Open-Smartwatch/open-smartwatch-light/docs/LILYGO-TTGO-Micro-32-V2-0.jpg

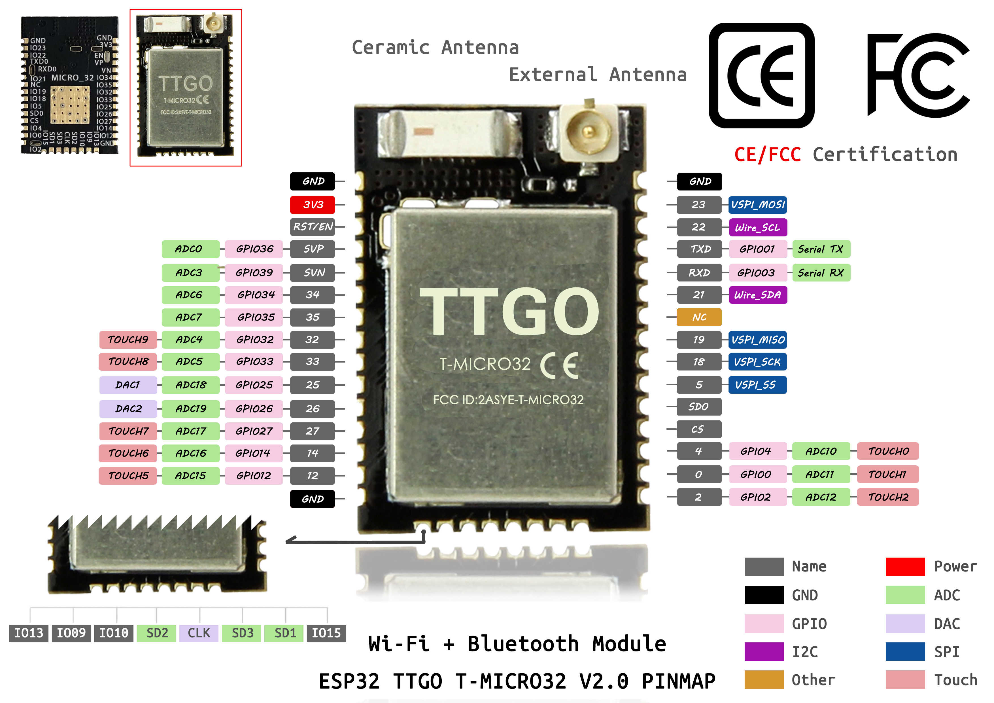
docs/LILYGO-TTGO-Micro-32-V2-0.jpg
