Open-Smartwatch/open-smartwatch-light/docs/TTGO-Micro-32-vs-ESP32-WROOM-32.jpg

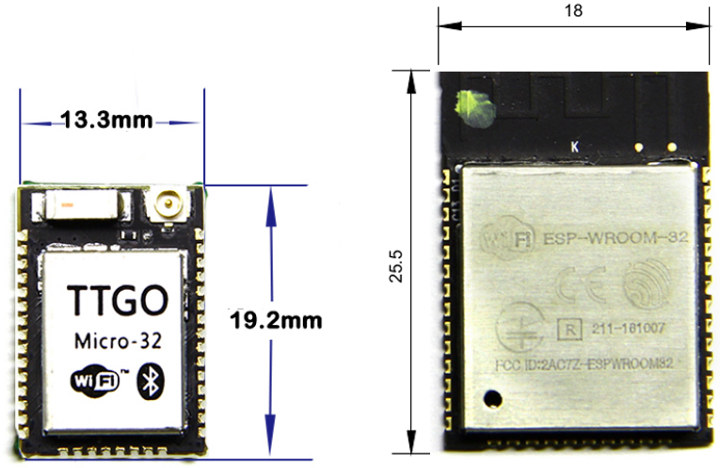
docs/TTGO-Micro-32-vs-ESP32-WROOM-32.jpg
