Open-Smartwatch/open-smartwatch-light/README.md

# Open-Smartwatch KiCAD files

Repo for kicad schematic, board and gerber files. This project is in development and is not ready for release.

## Tools

To view/modify the files from this repository, install KiCAD from: [https://kicad.org](https://kicad.org)

Also, add the following Symbol/Footprint library to KiCAD: [https://github.com/Open-Smartwatch/Kicad-Libraries](https://github.com/Open-Smartwatch/Kicad-Libraries)

## Schematic
Schematic

## Plots
front
bottom

## BOM

See: [https://htmlpreview.github.io/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](https://htmlpreview.github.io/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)
