Open-Smartwatch/open-smartwatch-light/docs/osw-schematic.pdf

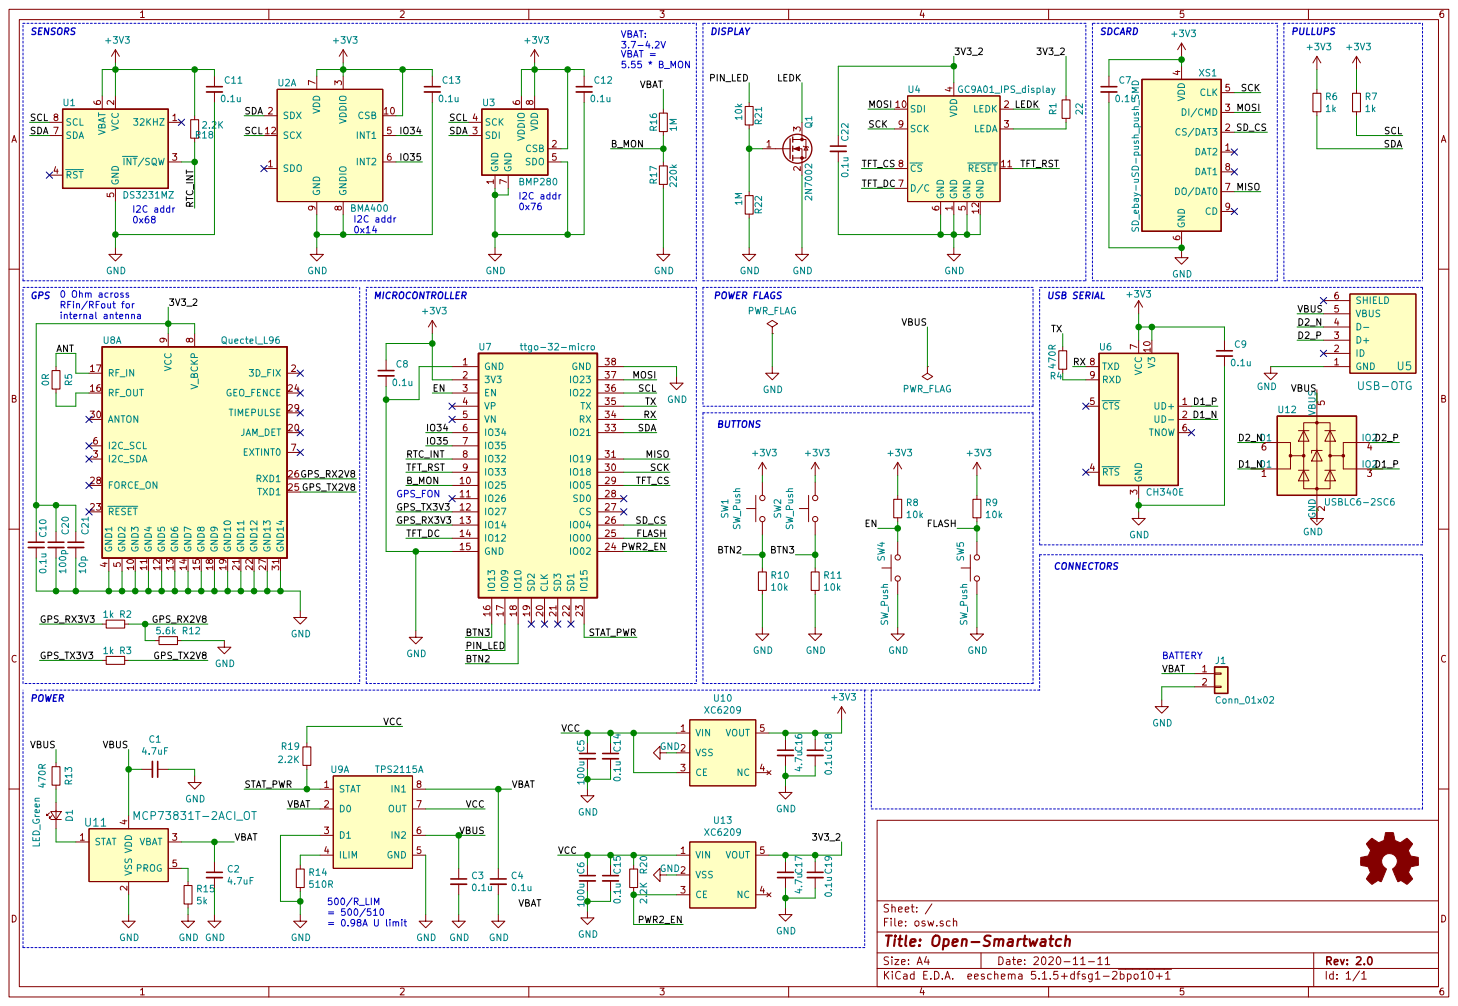
[picture p3: page 1]

6 DO/DAT0 7 DAT1 8 CD 9 XS1 SD_ebay-uSD-push_push_SMD R16 1M GND

1 CSB 2 SDI 3 SCK 4 SDO 5 VDDIO

0 Ohm across RFin/RFout for

3 RTS 4 CTS 5 TNOW 6 VCC

Id: 1/1 Title: Open-Smartwatch
