Open-Smartwatch/open-smartwatch-light/docs/osw-light-schematic.pdf

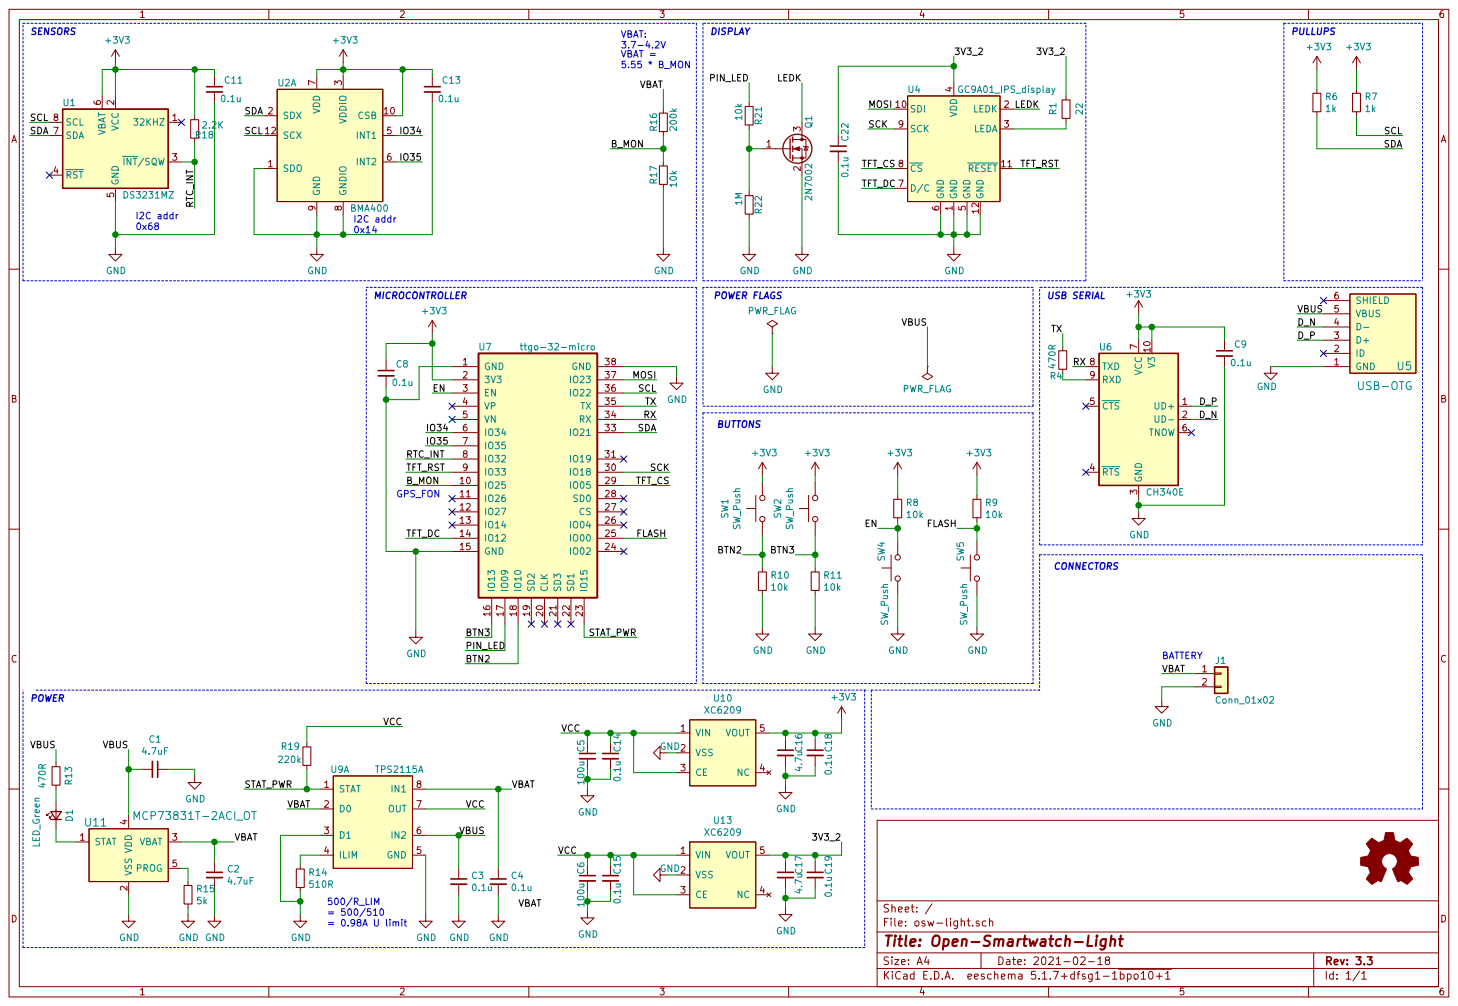
[picture p4: page 1]

3 RTS 4 CTS 5 TNOW 6 VCC

Id: 1/1 Title: Open-Smartwatch-Light
