Open-Smartwatch/open-smartwatch-light/(threads)

Thread 3 (2021-04-09):

Replace the micro32 module with an onboard esp32 pico d4

uvwxy, 2021-04-09:
The thickest part of the current design is the ttgo micro-32 module. If we place the esp pico d4 chip directly on the PCB we would get more space to maybe add additional ram (see GPS edition on how to add ram).

Electro707, 2021-04-10:
There is also the [ESP32­PICO­MINI­02](https://www.espressif.com/sites/default/files/documentation/esp32-pico-mini-02_datasheet_en.pdf) by Espressif, which is slightly smaller than the current module used (13.2×16.6×2.4mm).

Also by thickest you mean the biggest in size?

uvwxy, 2021-04-11:
> Also by thickest you mean the biggest in size?

yes.

uvwxy, 2021-04-11:
I'm also looking at developing a custom module fitting the footprint, that already includes the PSRAM for an additional 4MB RAM

uvwxy, 2021-04-13:
Update: the custom module is not going to work in a nice way.

Sharealikelicence, 2021-04-22:
Only issue I can see with this is getting FCC approval for the design to pass the RF leakage regulations etc.

Electro707, 2021-04-22:
> Only issue I can see with this is getting FCC approval for the design to pass the RF leakage regulations etc.

Well that should only apply if the watch is sold (and not as a kit). Otherwise as long as it's not poorly designed it shouldn't need approval/official testing (maybe tough a home-made test should be done just to make sure it doesn't spew crap out). At least as far as I'm aware.

Sharealikelicence, 2021-04-23:
Definitely not my field of expertise, but why does the micro32 board have FCC compliance as it is arguably sold in kit form? I'm thinking, for any commercial partners to pick up the design, RF leakage tests will have to be performed otherwise they probably won't take it on? I have no idea about that though.

Electro707, 2021-04-23:
Because the Micro32 is not sold as a kit, but instead as a module to be incorporated in a product. The advantage of the FCC compliance there is that the OEM using the module won't have to certify it for whatever certifications for intentional radiators it needs (they still need to do a Part15 non-intential radiator compliance, but that's one less certification/testing they need to do). As least as far as I'm aware.

As for this project, official FCC certification won't be required as it's not being sold (and if it is, it's done so as a hobbyist-oriented kit which is exempt from needing official certifications).

Sharealikelicence, 2021-04-27:
Yeah, I was thinking mainly designing it so it "should" pass FCC compliance, not actually do it. My original thought was to just duplicate the micro32 design onto the board. But, it's not open source, from what I can find, and I'm not sure about the copper layer count etc.

carlos-ramos-73, 2022-04-24:
> There is also the [ESP32­PICO­MINI­02](https://www.espressif.com/sites/default/files/documentation/esp32-pico-mini-02_datasheet_en.pdf) by Espressif, which is slightly smaller than the current module used (13.2×16.6×2.4mm).
>

I took a look into the ESP32 PICO MINI 02, It looks very promising for a replacement with the exception of the pads for soldering. Which, for an open source hobby kit, I think is a big deal when it comes to accessibility. But I do agree that if we can make it smaller, then it might be worth the tradeoff.

uvwxy, 2022-06-10:
Done with the latest design:

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

(there are still some bugs I need to resolve in the design. Patience ;) )

Closed 2022-06-10.

Thread 4 (2021-04-10):

Feature: Wireless Chargin

Electro707, 2021-04-10:
I think that a wireless charger built-in would be handy for everyday smartwatch usage. Preferably it should be Qi compliant so that any regular charger will work. Something like the [BQ51013B](https://www.ti.com/lit/ds/symlink/bq51013b.pdf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) or the [bq5105xB](https://www.ti.com/lit/ds/symlink/bq51050b.pdf?HQS=dis-dk-null-digikeymode-dsf-pf-null-wwe&ts=1618078894402) should work fine. Space on the board might be troublesome tough.

uvwxy, 2021-04-11:
Currently, in the deep sleep and tap to wake up configuration the battery can last over a week.

I'd prefer a magnetic clip/external interface versus wireless charging, especially due to the size constraints.

Maybe for a Version 4/ Version 5 :)

Tomaskocarter, 2021-06-19:
The only real benefit to wireless charging would be the increased water resistance imo.

Thread 5 (2021-04-22):

Feature: External Flash Memory

Sharealikelicence, 2021-04-22:
To allow users to change settings on their devices without having to re-flash the firmware and have them persist after a reboot, it would be handy to have a small amount of external memory (something like a [AT24C02C](https://www.microchip.com/wwwproducts/en/AT24C02C)) to be able to save the settings to.
This would then open up things like being able to change WiFi hotspots/passwords and default views on the fly.

Sharealikelicence, 2021-04-22:
Apparently the new esp pico d4 mentioned in #3 contains 4MB of integrated SPI flash memory which will make this feature request mute.

Closed 2021-04-22.

Thread 6 (2021-05-20):

Is it an option to customise the watch?

NavehKh, 2021-05-20:
Hi,

We are two friends in high school and we learn in a special program for youth at the university. As a final year project we chose to create a watch that has an alarm for deaf people.

The idea was to create a hand watch with pulse and movement sensors, a microphone, and a small electric shocker. When the time's up the watch sends little electric shocks until our guy is awake (what we learn from the sensors).

We looked all over the internet and we decided to use this DIY smartwatch as a basis for our project (this one - https://open-smartwatch.github.io/). It looked great, very functional and we can see you put a lot of effort in it.

We would like to know: can we plug the pulse sensor, the microphone, and the electric shocker to your open source smartwatch? Does the controlling unit (the ESP32-pico-D4) have input and output plugs that will allow us to connect the sensors to the watch?
If all the above are possible, we would like to get some help how to do it 🙏.

Thanks a lot in advance,

Eitan Givon and Naveh Khagbi

Electro707, 2021-05-31:
Assuming that the pulse sensor is an analog output, the module does have an internal ADC that can be used for that
For the shocker, depends on what it needs. If a 3.3v power rail will suffice, it can be done with a transistor switch configuration to drive it. Otherwise an internal boost converter can be used.
For the microphone, I would recommend some external microphone -> (I2C, SPI, or I2S) driver/interface as the internal ADC might not be fast enough for audio.

The watch PCB doesn't have pads to solder other stuff to it. And while you can hack in magnet wires to the ESP module and have an external circuitry for your peripherals, I would recommend forking the design and changing the PCB to fit your needs.

Closed 2022-06-09.

Thread 7 (2021-06-24):

Creating a smartphone App for the watch

kekko7072, 2021-06-24:
Hey I really like this open-sourche project.
I like to contribute developing a mobile phone app (using flutter) to connect the watch to iOS/Android smartphone.
To start using the clock and creating the app I will buy it from makerfabs the light edition and start developing.

I can comunicate with the watch through bluetooth, right?

Sensor now available:
+ Pedometer

In this first version of the app my goals will be:
+ Create a stable protocol of connection
+ Show Pedometer data in the app
+ Integration with Health Kit (Apple) and Google Fit.

For the future I'd like to use the data from this sensor:
+ Pulse sensor
+ Blood Oxygen Saturation
+ Altitude (I think is just in GPS version)

Using this sensor, In this second version of the app my goals will be:
+ Create sport watch  functions (ex. running)
+ Start showing notifications

I will develop it as open-source creating a mine Git repo for the project, when it will be stable and useful you could add to this git repo.
I 'm very excited for this new journey ;)

kekko7072, 2022-03-18:
Hey how can I enable Bluetooth on the watch ?

kekko7072, 2022-03-18:
Is BLE?

uvwxy, 2022-06-09:
> Hey how can I enable Bluetooth on the watch ?

Take a look at `src/apps/tools/ble_media_ctrl.cpp` as an example for a BLE app on the OSW. Make sure to disable/resize the screen buffer (like this example app) to have enough free memory for the BLE software stack on the ESP32.

(The next versions of the watch will have +2mb ram to solve this issue)

Another example is: https://github.com/SeanReg/open-smartwatch-os/commit/9464d2418e018018ba23f9c36357525ee7722e2f

kekko7072, 2022-06-26:
@uvwxy Thanks for the example, I will start from that. But can you explain me or there is a guide I can follow to start building app for the OSW? Because I'm trying to reverse engineer the OSW but I'm not able to understand where to start to code and make my app run in the OSW, I mean where should I add in the main to access it?

RuffaloLavoisier, 2022-06-26:
@kekko7072 Could you add me in the Discord?

kekko7072, 2022-06-27:
Sure my discord is kekko7072#2399 I'm already in the discord channel but I'm not ver active.

kekko7072, 2022-06-27:
@RuffaloLavoisier Are you able to build ble code for OSW, I'm trying to connect but with not so much success?

RuffaloLavoisier, 2022-06-27:
@kekko7072 Can you please leave a message? I send discord to you. Plz check it.

yacubovvs, 2022-06-27:
> @uvwxy Thanks for the example, I will start from that. But can you explain me or there is a guide I can follow to start building app for the OSW? Because I'm trying to reverse engineer the OSW but I'm not able to understand where to start to code and make my app run in the OSW, I mean where should I add in the main to access it?

https://github.com/yacubovvs/CubOS/tree/main/tools/CubOSBLEApp  - Android example for arduino esp32 watch via BLE. Not best example, but it works

Closed 2022-06-08.

Thread 9 (2021-08-22):

html page

AluUriel, 2021-08-22:
What tool did you use to create the HTML where I can visualize the PCB? I like to create a similar one. Thanks
I mean this page https://htmlpreview.github.io/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

mikini, 2022-06-16:
HTML title hints at [Interactive HTML BOM generation plugin for KiCad](https://github.com/openscopeproject/InteractiveHtmlBom) ;).

Thread 10 (2021-10-16):

Sleep interrupt esp_sleep_enable_ext1_wakeup

yacubovvs, 2021-10-16:
It is not possible to use a mask to interrupt sleep by pressing all the buttons. GPIO13 and GPIO10 are not RTC_PINs.
It's a good idea to change the contacts, perhaps to GPIO27 and GPIO14. And reverse GPIO00 to another pin. The wake-up mode esc_sleep_enable_ext 1_wakeup only works with "any high output", but GPIO00 is still HIGH when not pressed

uvwxy, 2022-06-09:
Thanks for your input. I have changed this with the latest version I am working on!

Closed 2022-06-09.

Thread 11 (2021-10-16):

Change  screen led current

yacubovvs, 2021-10-16:
It may be worth adding another mosfet 2N7002 and making 2 channels for controlling the backlight PIN_LED1 and PIN_LED 2 with current-limiting resistors 30 and 83 ohms. The combination of enabling these ports will allow to limit the backlight current to one of the following values - 22 ohms, 30 ohms, 83 ohms or infinite resistance (for power off). This will reduce the backlight current by 3.7 times in energy-saving mode.

This will be useful because the PWM of the ESP 32 does not work in sleep mode

uvwxy, 2022-06-09:
I ran out of space on the PCB of the Light Revision 4.2...

Thread 12 (2024-02-12):

Adding a vibration motor

Newchair2644, 2024-02-12:
Hi, I was looking into this project and think its amazing how open everything is to be modified by anyone! Wondering if there are pins on the back that can be used for a small vibration motor. If not, can it be done with some careful soldering directly to the esp module? I would modify the pcb but do not know how... I apologize in advance if this is not the appropriate place to ask!

Thread 13 (2025-02-17):

Possible Type C version?

tuxy, 2025-02-17:
Hiya! I found the OSW project today and was wondering if Type C could be considered instead of Micro B for the lite variant. I have (tried) to design and fit a JAE DX07S016 receptacle, and wired it up.

Questions I have:
- Are you guys considering adding type C in the first place?
- How much space is needed to fit in the receptacle?
- And how would the case need to be modified? (if at all)

No prototypes have been made yet, but I'm planning to get some and test soon if that's what you guys need

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

Closed 2025-02-18.
