Open-Smartwatch/open-smartwatch-light/(commit log)

2020-09-06 add symbols/footprints
    [os-v1.0.kicad_pcb, os-v1.0.sch]
2020-09-06 sch: wire reset/flash, board: switch button placement
    [os-v1.0.kicad_pcb, os-v1.0.sch]
2020-09-07 throw more symbols/footprints at it
    [os-v1.0.kicad_pcb, os-v1.0.sch]
2020-09-08 add bma400, bme280, ds3231mz
    [os-v1.0.kicad_pcb, os-v1.0.sch]
2020-09-09 organizes and wires schematic
    [os-v1.0.kicad_pcb, os-v1.0.sch]
2020-09-09 adds schematic as pdf
2020-09-09 updates pcb with pullups
    [os-v1.0.kicad_pcb]
2020-09-09 2-lyr ground pour
    [os-v1.0.kicad_pcb]
2020-09-09 adds RF shunt resistor to pcb
    [os-v1.0.kicad_pcb]
2020-09-09 minor symbol lib changes and display lib update for SPI
    [os-v1.0.sch]
2020-09-10 adds batt mon volt div
    [os-v1.0.sch]
2020-09-10 routes gps uart and display spi
    [os-v1.0.kicad_pcb, os-v1.0.sch]
2020-09-10 updates bom
2020-09-10 change pin mappings for gps uart
    [os-v1.0.sch]
2020-09-10 update schematic using @evilmonkeyz review feedback
    [os-v1.0.kicad_pcb, os-v1.0.sch]
2020-09-10 fix gps footprint
    [os-v1.0.kicad_pcb]
2020-09-11 add micro coaxial ext. antenna connector
    [os-v1.0.kicad_pcb, os-v1.0.sch]
2020-09-24 latest changes
    [os-v1.0.kicad_pcb, os-v1.0.sch]
2020-09-25 add ltc3440
    [os-v1.0.kicad_pcb, os-v1.0.sch]
2020-09-26 reorganize ic decoupling in schematics, move componetns from pcb into groups
    [os-v1.0.kicad_pcb, os-v1.0.sch]
2020-09-26 reorganize components
    [os-v1.0.kicad_pcb, os-v1.0.sch]
2020-09-26 huge mess with wires
    [os-v1.0.kicad_pcb, os-v1.0.sch]
2020-09-27 remove all tracks, to start over
    [os-v1.0.kicad_pcb]
2020-09-27 connect power circuit + GND
    [os-v1.0.kicad_pcb]
2020-09-27 connet GND + 3V3
    [os-v1.0.kicad_pcb]
2020-09-27 connect gps
    [os-v1.0.kicad_pcb]
2020-09-27 connect gps nicer
    [os-v1.0.kicad_pcb]
2020-09-27 connect more stuff
    [os-v1.0.kicad_pcb]
2020-09-27 final tracks
    [os-v1.0.kicad_pcb]
2020-09-28 fix pad of bma400, rewire
    [os-v1.0.kicad_pcb, os-v1.0.sch]
2020-09-28 version sent to fab
    [os-v1.0.kicad_pcb]
2020-09-29 avoid traces under the inductor
    [os-v1.0.kicad_pcb, os-v1.0.sch]
2020-09-29 reset layers
    [os-v1.0.kicad_pcb]
2020-09-29 fix 3V3 plane
    [os-v1.0.kicad_pcb]
2020-09-30 fix ltc3440
    [os-v1.0.kicad_pcb, os-v1.0.sch]
2020-11-10 reorganized all files
    [osw.kicad_pcb, osw.sch]
2020-11-10 added kicad-exports
2020-11-10 PCB version was not set
    [osw.kicad_pcb]
2020-11-11 update .gitignore, fix battery mon resistors
    [osw.sch]
2020-11-11 add LED FET protection
    [osw.sch]
2020-11-11 set i2c pullups to 1k
    [osw.sch]
2020-11-11 add USB protection USBLC6-2SC6
    [osw.sch]
2020-11-11 add 3V3 to 2V8 Uart shifter
    [osw.sch]
2020-11-11 disconnect GPS_FON
    [osw.sch]
2020-11-11 replace ltc3440 with 2x XC6209
    [osw.sch]
2020-11-11 bump rev to 2.0
    [osw.sch]
2020-11-11 update PCB, place components randomly
    [osw.kicad_pcb, osw.sch]
2020-11-14 update board to rev2.0
    [osw.kicad_pcb, osw.sch]
2020-11-15 finalize v2.0
    [osw.kicad_pcb]
2020-11-16 add more silk screen labels
    [osw.kicad_pcb, osw.sch]
2020-11-18 osw light v1.0
    [osw-3V3_v.gbr, osw-B_Adhes_v.gbr, osw-B_CrtYd_v.gbr, osw-B_Cu_v.gbr, osw-B_Fab_v.gbr, osw-B_Mask_v.gbr, osw-B_Paste_v.gbr, osw-B_SilkS_v.gbr]
2020-11-18 update kicad-exports
2020-11-18 fix version numbers
    [osw-light.kicad_pcb, osw-light.sch]
2020-11-19 replace circle with 4x arc
    [osw-light.kicad_pcb]
2020-11-20 upgrade kicad-exports
2020-12-27 fix flashing, cleanup BMA400 placement
    [osw-light.kicad_pcb, osw-light.sch]
2021-01-03 rev 3.1, remove bme280, improve layout
    [osw-light.kicad_pcb, osw-light.sch]
2021-01-03 fix lables
    [osw-light.kicad_pcb]
2021-01-11 remove old gerbers
    [osw-light-B_Adhes_v.gbr, osw-light-B_CrtYd_v.gbr, osw-light-B_Cu_v.gbr, osw-light-B_Fab_v.gbr, osw-light-B_Mask_v.gbr, osw-light-B_Paste_v.gbr, osw-light-B_SilkS_v.gbr, osw-light-Cmts_User_v.gbr]
2021-01-17 rev 3.2: set R19 to 220k - improve standby from 2mA to 0.35mA
    [osw-light.kicad_pcb, osw-light.sch]
2021-01-17 fix moving R19 by mistake
    [osw-light.kicad_pcb]
2021-01-17 PCB: Change R19 value from 2.2K to 220k.
    [osw-light.kicad_pcb]
2021-02-18 rev 3.3 - fix ttgo32 footprint
    [osw-light.kicad_pcb, osw-light.sch]
